afonsus1997/yet-another-pico-gb-printer/README.md

# Yet Another Pico GB Printer

## Acknowledgements 
Based on the [The-TinyGB-Printer](https://github.com/Raphael-Boichot/The-TinyGB-Printer) by [Raphael-Boichot](https://github.com/Raphael-Boichot)
