afonsus1997/yet-another-pico-gb-printer/hardware/yet-another-pico-gb-printer/yet-another-pico-gb-printer.kicad_pcb

## KiCad design hardware/yet-another-pico-gb-printer/yet-another-pico-gb-printer.kicad_pcb (2024-12-13)

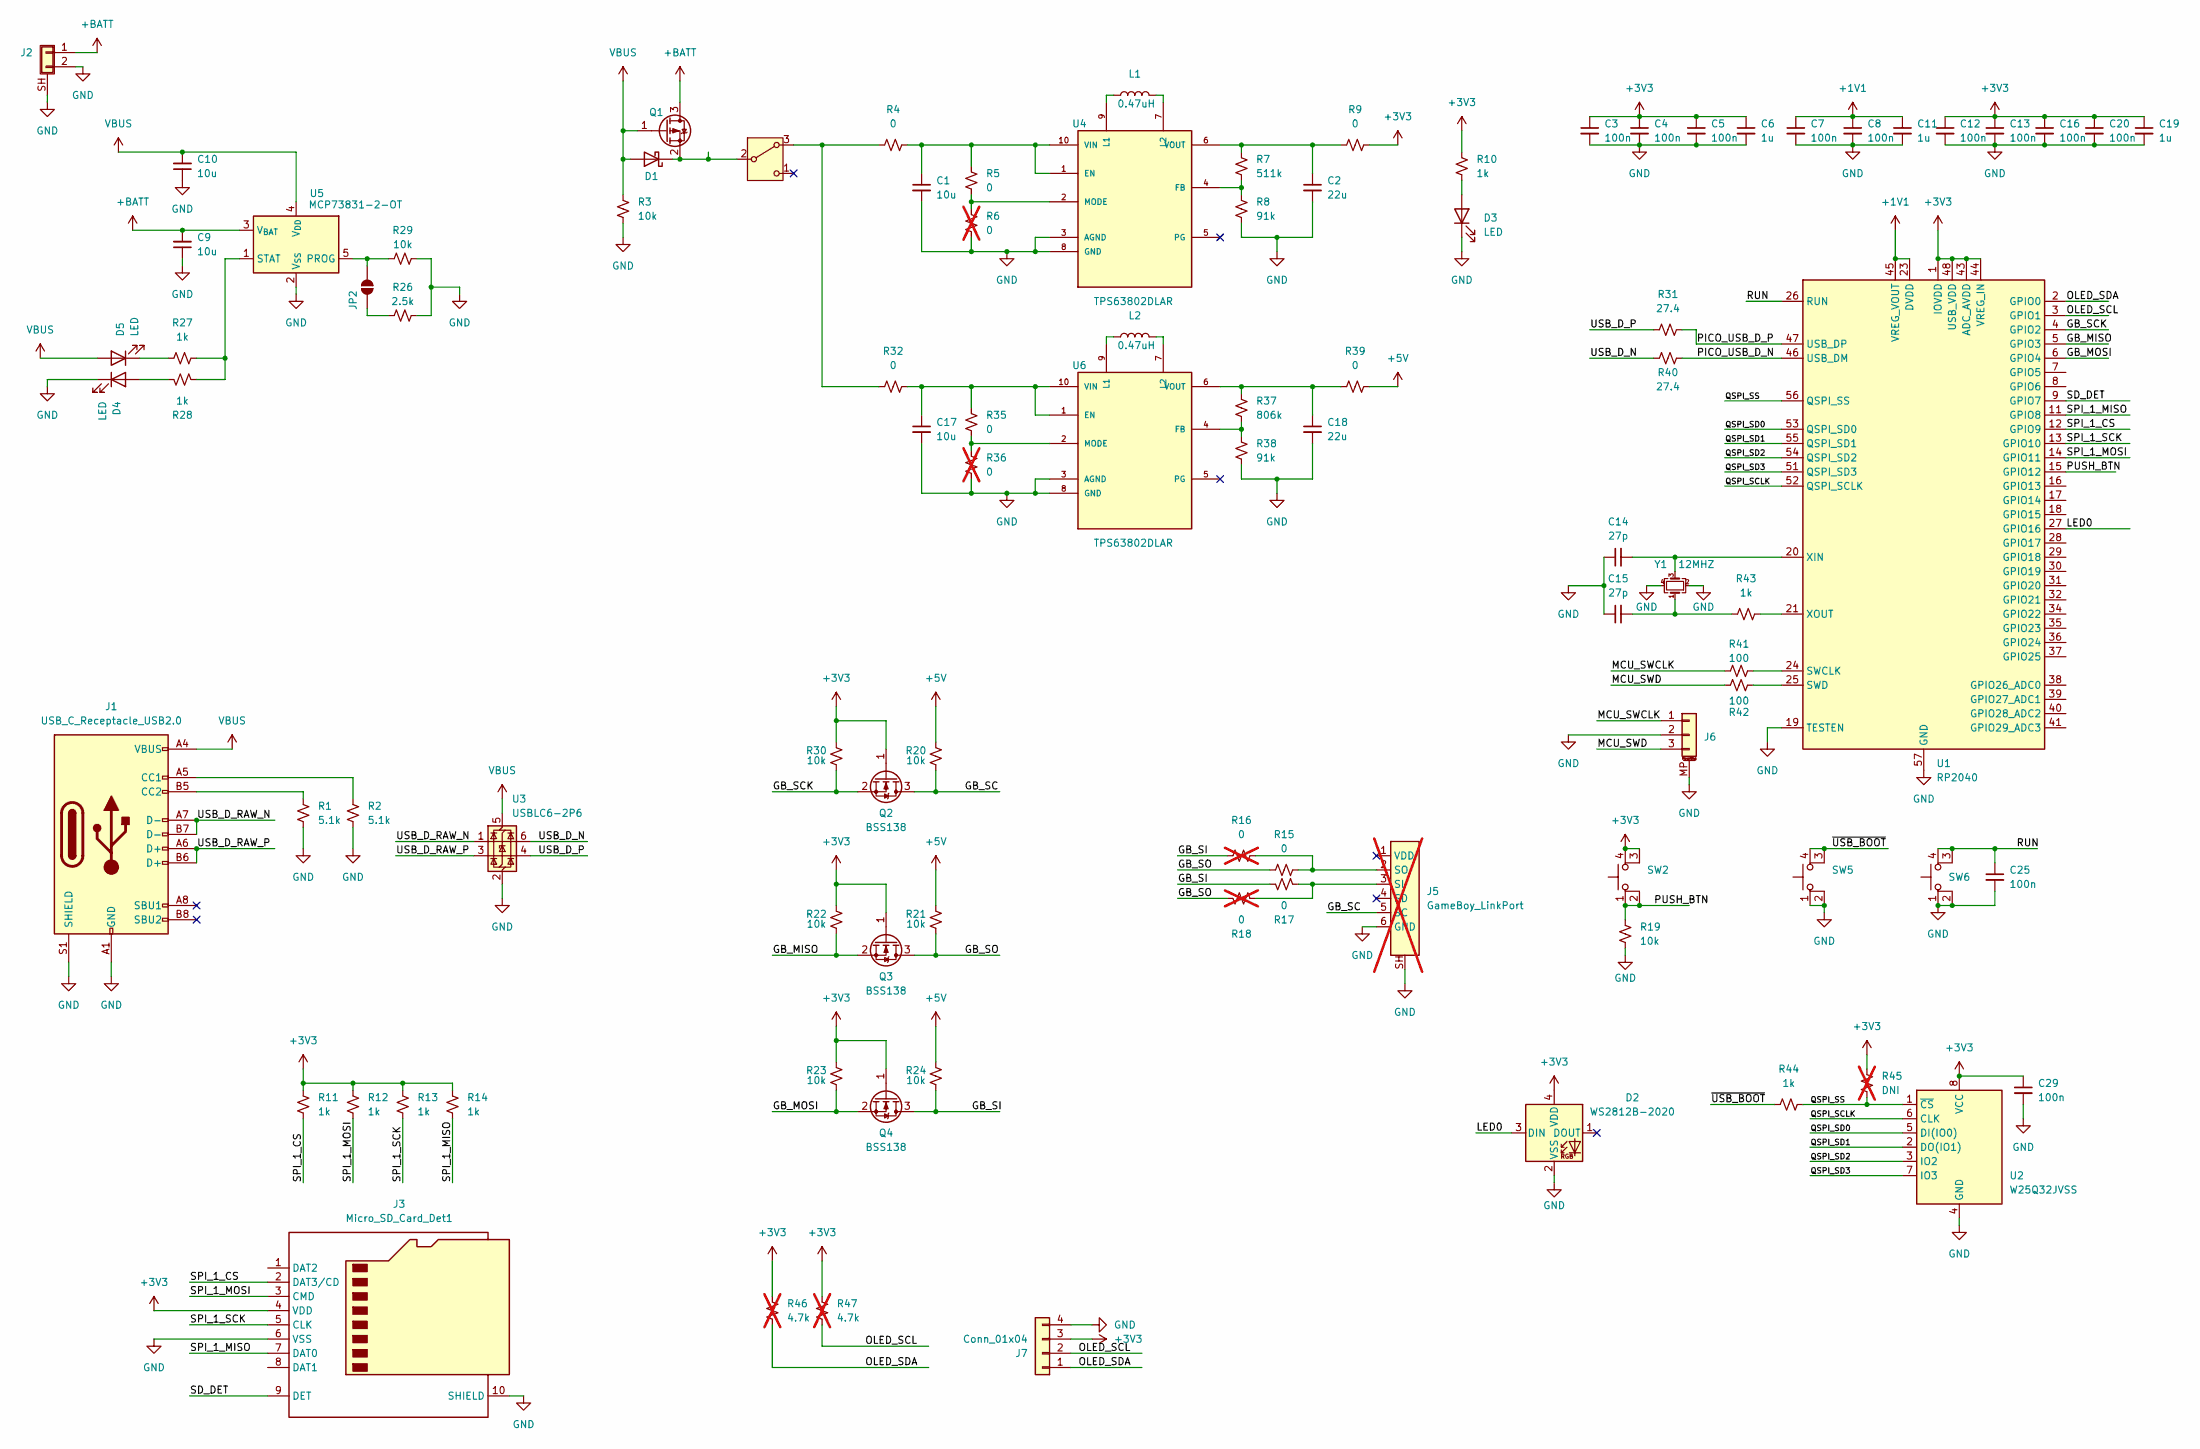
[picture p1: schematic yet-another-pico-gb-printer.kicad_sch]

Parts:
C1, C9, C10, C17: 10u; C_0603_1608Metric; LCSC C95839
C2, C18: 22u; C_0603_1608Metric; LCSC C59461
C3, C4, C5, C7, C8, C12, C13, C16, C20, C29: 100n; C_0402_1005Metric; LCSC C60474
C6, C11, C19: 1u; C_0402_1005Metric; LCSC C14445
C14, C15: 27p; C_0603_1608Metric; LCSC C107002
C25: 100n; C_0603_1608Metric; LCSC C60474
D1: D_Schottky; D_SOD-123F; LCSC C50553
D2: WS2812B-2020; LED_WS2812B-2020_PLCC4_2.0x2.0mm; LCSC C965555
D3, D4, D5: LED; LED_0603_1608Metric; LCSC C434424
J1: USB_C_Receptacle_USB2.0; USB_C_Receptacle_HCTL_HC-TYPE-C-16P-01A; LCSC C2894897
J2: Conn_01x02_Shielded; CONN-SMD_P2.00_S2B-PH-SM4-TB-LF-SN; LCSC C295747
J3: Micro_SD_Card_Det1; J_sd_micro_socket_no_holes; LCSC C7529389
J5: GameBoy_LinkPort; GBA-LINK; not fitted
J6: Conn_01x03_MountingPin; JST_SH_SM03B-SRSS-TB_1x03-1MP_P1.00mm_Horizontal; LCSC C160403
J7: Conn_01x04; OLED_SSD1306_128x32_0.91
JP2: SolderJumper_2_Open; SolderJumper-2_P1.3mm_Open_Pad1.0x1.5mm
L1, L2: 0.47uH; L_Wurth_WE-LQSH-2010; LCSC C89446
Q1: DMG3415U; SOT-23; LCSC C96616
Q2, Q3, Q4: BSS138; SOT-23; LCSC C5337205
R1, R2: 5.1k; R_0402_1005Metric; LCSC C105872
R3, R19, R20, R21, R22, R23, R24, R29, R30: 10k; R_0402_1005Metric; LCSC C60490
R4, R5, R9, R15, R17, R32, R35, R39: 0; R_0402_1005Metric; LCSC C106231
R6, R16, R18, R36: 0; R_0402_1005Metric; LCSC C106231; not fitted
R7: 511k; R_0402_1005Metric; LCSC C5126239
R8, R38: 91k; R_0402_1005Metric; LCSC C852952
R10, R11, R12, R13, R14, R27, R28, R43, R44: 1k; R_0402_1005Metric; LCSC C11702
R26: 2.5k; R_0402_1005Metric; LCSC C145071
R31, R40: 27.4; R_0402_1005Metric; LCSC C172043
R37: 806k; R_0402_1005Metric; LCSC C3016043
R41, R42: 100; R_0402_1005Metric; LCSC C25076
R45: DNI; R_0402_1005Metric; not fitted
R46, R47: 4.7k; R_0603_1608Metric; LCSC C99782; not fitted
SW2: SW_MEC_5E; SW-SMD_4P-L5.2-W5.2-P3.70-LS6.4; LCSC C2686853
SW3: SW_SPDT_321; SW-SMD_K3-1280S-L1; LCSC C223845
SW5, SW6: SW_MEC_5E; SW_SKRPACE010; LCSC C139797
U1: RP2040; QFN-56-1EP_7x7mm_P0.4mm_EP3.2x3.2mm; LCSC C2040
U2: W25Q32JVSS; Winbond_USON-8-1EP_3x2mm_P0.5mm_EP0.2x1.6mm; LCSC C2843335
U3: USBLC6-2P6; SOT-666; LCSC C2827693
U4, U6: TPS63802DLAR; VREG_TPS63802DLAR; PARTREV B; LCSC C2845237
U5: MCP73831-2-OT; SOT-23-5; LCSC C625600
Y1: 12MHZ; Crystal_SMD_3225-4Pin_3.2x2.5mm; LCSC C5182760

Connections:
+1V1: C7.1, C8.1, C11.1, U1.23 (DVDD), U1.45 (VREG_VOUT), U1.50 (DVDD)
+3V3: C3.1, C4.1, C5.1, C6.1, C12.1, C13.1, C16.1, C19.1, C20.1, C29.1, D2.4 (VDD), J3.4 (VDD), J7.3, Q2.1 (G), Q3.1 (G), Q4.1 (G), R9.2, R10.2, R11.2, R12.2, R13.2, R14.2, R22.1, R23.1, R30.1, R45.1, R46.1, R47.1, SW2.3 (K), SW2.4 (A), U1.1 (IOVDD), U1.10 (IOVDD), U1.22 (IOVDD), U1.33 (IOVDD), U1.42 (IOVDD), U1.43 (ADC_AVDD), U1.44 (VREG_IN), U1.48 (USB_VDD), U1.49 (IOVDD), U2.8 (VCC)
+5V: R20.1, R21.1, R24.1, R39.2
+BATT: C9.2, J2.1, Q1.3 (D), U5.3 (V_{BAT})
/GB_MISO: Q3.2 (S), R22.2, U1.5 (GPIO3)
/GB_MOSI: Q4.2 (S), R23.2, U1.6 (GPIO4)
/GB_SC: J5.5 (SC), Q2.3 (D), R20.2
/GB_SCK: Q2.2 (S), R30.2, U1.4 (GPIO2)
/GB_SI: Q4.3 (D), R16.1, R17.1, R24.2
/GB_SO: Q3.3 (D), R15.1, R18.1, R21.2
/LED0: D2.3 (DIN), U1.27 (GPIO16)
/MCU_SWCLK: J6.1, R41.1
/MCU_SWD: J6.3, R42.1
/OLED_SCL: J7.2, R47.2, U1.3 (GPIO1)
/OLED_SDA: J7.1, R46.2, U1.2 (GPIO0)
/PICO_USB_D_N: R40.2, U1.46 (USB_DM)
/PICO_USB_D_P: R31.2, U1.47 (USB_DP)
/PUSH_BTN: R19.1, SW2.1, SW2.2, U1.15 (GPIO12)
/QSPI_SCLK: U1.52 (QSPI_SCLK), U2.6 (CLK)
/QSPI_SD0: U1.53 (QSPI_SD0), U2.5 (DI(IO0))
/QSPI_SD1: U1.55 (QSPI_SD1), U2.2 (DO(IO1))
/QSPI_SD2: U1.54 (QSPI_SD2), U2.3 (IO2)
/QSPI_SD3: U1.51 (QSPI_SD3), U2.7 (IO3)
/QSPI_SS: R44.2, R45.2, U1.56 (QSPI_SS), U2.1 (~CS)
/RUN: C25.1, SW6.3 (K), SW6.4 (A), U1.26 (RUN)
/SD_DET: J3.9 (DET), U1.9 (GPIO7)
/SPI_1_CS: J3.2 (DAT3/CD), R11.1, U1.12 (GPIO9)
/SPI_1_MISO: J3.7 (DAT0), R14.1, U1.11 (GPIO8)
/SPI_1_MOSI: J3.3 (CMD), R12.1, U1.14 (GPIO11)
/SPI_1_SCK: J3.5 (CLK), R13.1, U1.13 (GPIO10)
/USB_D_N: R40.1, U3.6 (I/O1)
/USB_D_P: R31.1, U3.4 (I/O2)
/USB_D_RAW_N: J1.A7 (D-), J1.B7 (D-), U3.1 (I/O1)
/USB_D_RAW_P: J1.A6 (D+), J1.B6 (D+), U3.3 (I/O2)
/~USB_BOOT: R44.1, SW5.3 (K), SW5.4 (A)
GND: C1.2, C2.2, C3.2, C4.2, C5.2, C6.2, C7.2, C8.2, C9.1, C10.1, C11.2, C12.2, C13.2, C14.1, C15.1, C16.2, C17.2, C18.2, C19.2, C20.2, C25.2, C29.2, D2.2 (VSS), D3.1 (K), D4.1 (K), J1.A1 (GND), J1.A12 (GND), J1.B1 (GND), J1.B12 (GND), J1.S1 (SHIELD), J2.2, J2.SH (Shield), J3.6 (VSS), J3.10 (SHIELD), J5.6 (GND), J5.SH, J6.2, J6.MP (MountPin), J7.4, R1.2, R2.2, R3.2, R6.1, R8.2, R19.2, R26.1, R29.1, R36.1, R38.2, SW5.1, SW5.2, SW6.1, SW6.2, U1.19 (TESTEN), U1.57 (GND), U2.4 (GND), U3.2 (GND), U4.3 (AGND), U4.8 (GND), U5.2 (V_{SS}), U6.3 (AGND), U6.8 (GND), Y1.2, Y1.4
unnamed: C15.2, R43.1, Y1.1
unnamed: D1.1 (K), Q1.2 (S), SW3.2 (B)
unnamed: D3.2 (A), R10.1
unnamed: D4.2 (A), R28.2
unnamed: D5.1 (K), R27.2
unnamed: J1.A5 (CC1), R2.1
unnamed: J1.B5 (CC2), R1.1
unnamed: J5.3 (SI), R17.2, R18.2
unnamed: J5.2 (SO), R15.2, R16.2
unnamed: JP2.1 (A), R26.2
unnamed: JP2.2 (B), R29.2, U5.5 (PROG)
unnamed: R4.1, R32.1, SW3.3 (A)
unnamed: R41.2, U1.24 (SWCLK)
unnamed: R42.2, U1.25 (SWD)
unnamed: C14.2, U1.20 (XIN), Y1.3
unnamed: R43.2, U1.21 (XOUT)
unnamed: C1.1, R4.2, R5.2, U4.1 (EN), U4.10 (VIN)
unnamed: R7.2, R8.1, U4.4 (FB)
unnamed: L1.1, U4.9 (L1)
unnamed: L1.2, U4.7 (L2)
unnamed: R5.1, R6.2, U4.2 (MODE)
unnamed: C2.1, R7.1, R9.1, U4.6 (VOUT)
unnamed: R27.1, R28.1, U5.1 (STAT)
unnamed: C17.1, R32.2, R35.2, U6.1 (EN), U6.10 (VIN)
unnamed: R37.2, R38.1, U6.4 (FB)
unnamed: L2.1, U6.9 (L1)
unnamed: L2.2, U6.7 (L2)
unnamed: R35.1, R36.2, U6.2 (MODE)
unnamed: C18.1, R37.1, R39.1, U6.6 (VOUT)
VBUS: C10.2, D1.2 (A), D5.2 (A), J1.A4 (VBUS), J1.A9 (VBUS), J1.B4 (VBUS), J1.B9 (VBUS), Q1.1 (G), R3.1, U3.5 (VBUS), U5.4 (V_{DD})

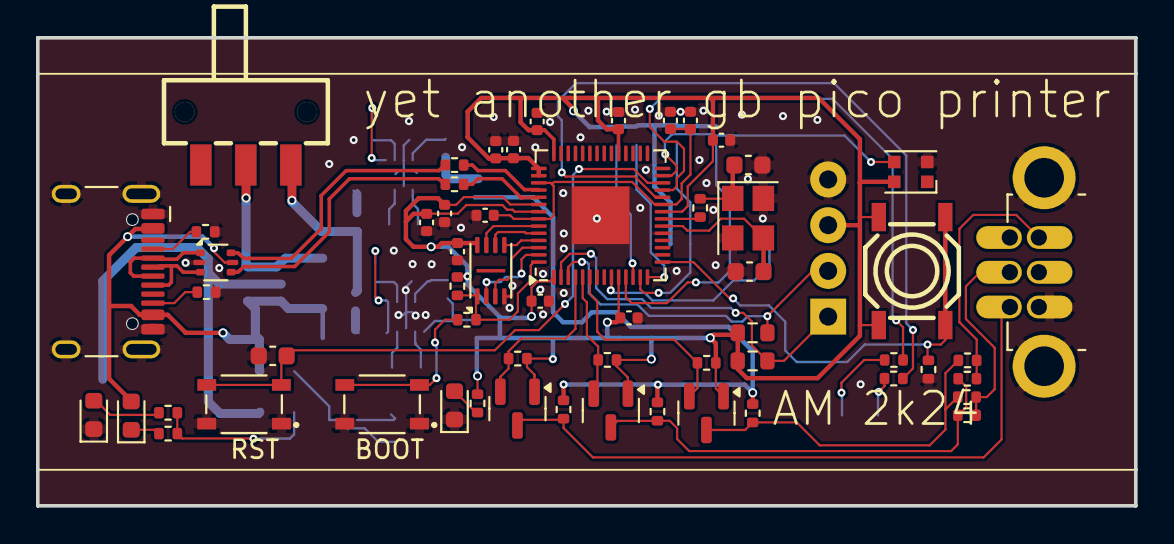
[picture p2: board yet-another-pico-gb-printer.kicad_pcb from above]

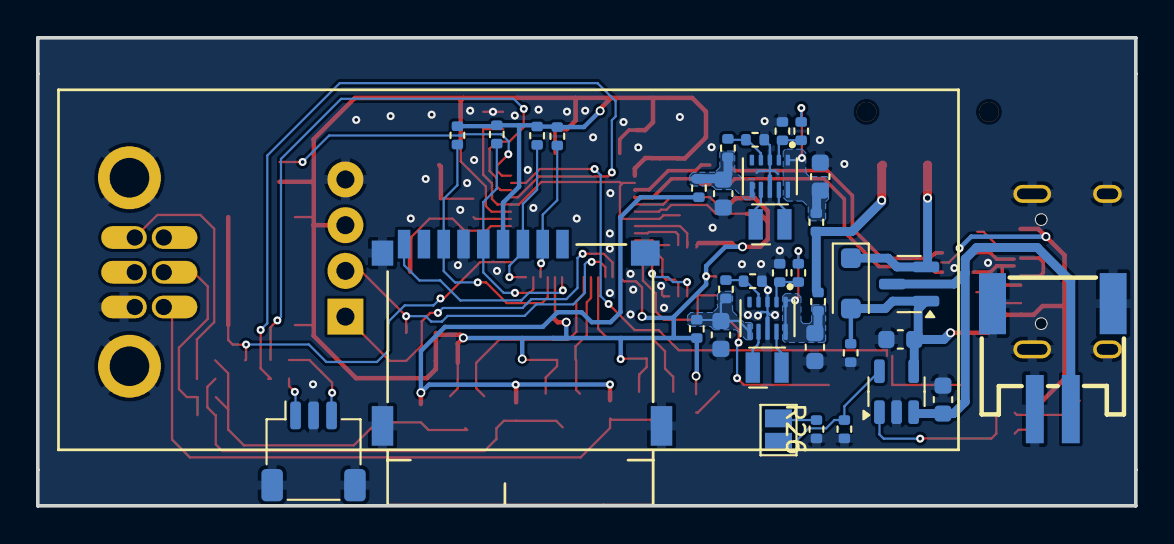
[picture p3: board yet-another-pico-gb-printer.kicad_pcb from below]

Board: 4 copper layers, 61.0 x 26.0 mm, 95 parts (36 on the bottom side), 66 nets.
