afonsus1997/yet-another-pico-gb-printer/(commit log)

2024-12-11 added libs and schematic
    [NeoGB-Printer-ESP32.kicad_pcb, NeoGB-Printer-ESP32.kicad_sch]
2024-12-12 more schematic and layout
    [NeoGB-Printer-ESP32.kicad_pcb, NeoGB-Printer-ESP32.kicad_sch]
2024-12-12 changed project name
    [NeoGB-Printer-ESP32.kicad_pcb, NeoGB-Printer-ESP32.kicad_sch, yet-another-pico-gb-printer.kicad_pcb, yet-another-pico-gb-printer.kicad_sch]
2024-12-12 removed old project
    [NeoGB-Printer-ESP32.kicad_pcb, NeoGB-Printer-ESP32.kicad_sch]
2024-12-12 schematics and layout improvements
    [yet-another-pico-gb-printer.kicad_pcb, yet-another-pico-gb-printer.kicad_sch]
2024-12-13 sent to fab
    [yet-another-pico-gb-printer.kicad_pcb, yet-another-pico-gb-printer.kicad_sch]
2024-12-13 minor changes for jlc
    [yet-another-pico-gb-printer.kicad_pcb]
